dathanho/bjt-hard-clipping-overdrive/schematics/bjt-hard-clipping-overdrive-dh.asc

C1: cap; 22nF
C2: cap; 10nF
C3: cap; 220nF
C4: cap; 0.1µF
C5: cap; 0.1µF
C6: cap; 100µF
C7: cap; 0.1µF
D1: schottky; 1N4148_CUSTOM
D2: diode; 1N4148_CUSTOM
D3: schottky; BAT41
EFFECT_STATUS: LED
PLUG_CONTROL: voltage; 5
POWER_STATUS: LED
Q1: npn; 2N3904_CUSTOM
Q2: npn; 2N3904_CUSTOM
R1: res; 1Meg
R2: res; 2.2Meg
R3: res; 470k
R4: res; 470
R5: res; 10k
R6: res; 470
R7: res; 470
R8: res; 1.5k
R9: res; 1Meg
R10: res; 470k
R11: res; 2.2Meg
R12: res; 100
R13: res; 10k
R14: res; 4.7k
R15: res; 2.2k
RING_SLEEVE_BRIDGE: sw; PLUG
S1: sw; ROW1
S2: sw; ROW1
S3: sw; ROW1
S4: sw; ROW3
S5: sw; ROW3
S6: sw; ROW3
V_BATT: voltage; 9V
V_GUITAR: voltage; SINE(0 0.1 1000); AC 1
V_Switches: voltage; 5
VR1: res; 100k
VR2: res; 100k
Named nets: 0, V_Switch, Input, Circuit_In, LED_Neg, Output, Circuit_Out, 9V_Source, V_Plug
.model ROW1 SW(Vt=2.5 Vh=-0.1 Ron=1e-6 Roff=1e12)
.model ROW3 SW(Vt=2.5 Vh=-0.1 Ron=1e12 Roff=1e-6)
.tran 0.01
.model PLUG SW(Vt=2.5 Vh=-0.1 Ron=1e-6 Roff=1e12)
SWITCH
POWER, STATUS LEDs
EFFECT
.model 2N3904_CUSTOM NPN(Is=1e-14 Bf=200 Rc=1.5 Re=0.5)
.model 1N4148_CUSTOM D(Is=2.52n N=1.75 Rs=0.56 Cjo=4p Vj=0.75 M=0.33 TT=5.76n BV=100 IBV=25n)
.model BAT41 D(Is=100n N=1.05 Rs=1.2 Cjo=3.5p Vj=0.4 M=0.33 TT=0 BV=100 IBV=100n)
BUFFER
GAIN_POT
VOLUME_POT
Dathan Ho - 2026
A100k
A100k
